IRDG/Invenio-RISCV/Documents/RiscV CompleteVersion ESP.pptx

## DISEÑO DE UN PROTOTIPO DE CONTROLADOR PID EN DRONES CON PROCESADOR A LA MEDIDA EN ARQUITECTURA RISC-V PARA IMPLEMENTACIÓN EN FPGA

- Autores:
  - Iván Ricardo Diaz Gamarra
  - Omar Steck Espinel Santamaria
  - Magda Daniela Latorre Ortiz
- Director:
  - Ing. Francisco F. Viveros, Profesor Emérito.
- Codirector:
  - Ing. Luisa F. García, Ph. D.

Notes: Omar

## Introducción

Definición de la arquitectura del procesador
Diseño de la ALU: Enfoque en suma y multiplicación
Proceso de implementación y pruebas
Descripción de control en AHPL
Formulación del proyecto - Investigación del estándar RISC-V

Notes: Daniela

## CONTEXTO DEL PROYECTO

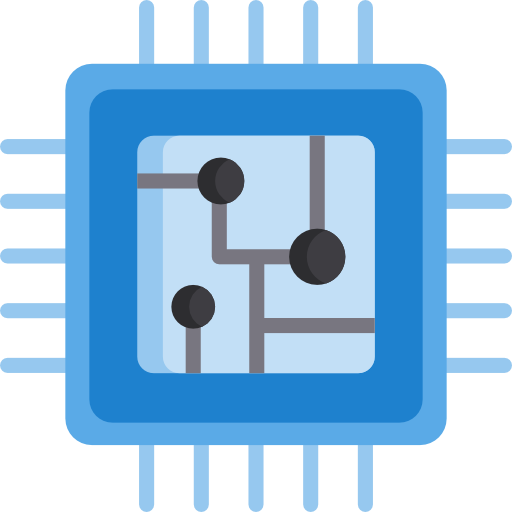
[picture p4: figure]

¿Estándares para la arquitectura de procesadores?

Iniciativas para crear un estándar para la arquitectura de procesadores.

Proyectos que permitan aplicar la arquitectura a procesadores de propósito especifico.

Notes: Omar

## FORMULACION DEL PROBLEMA

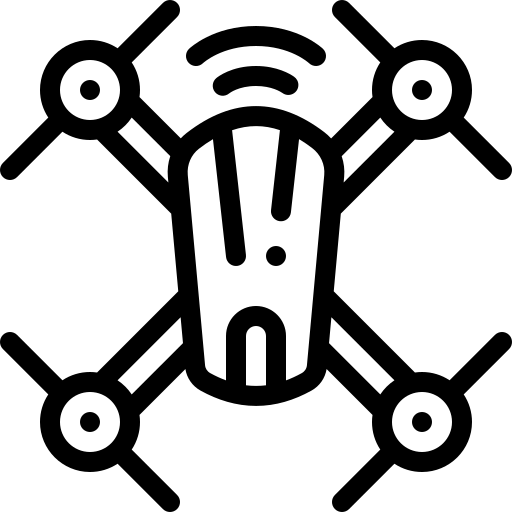
[picture p5: figure]

La ausencia de una arquitectura libre, documentada y abierta, en el ámbito de los procesadores usados en controladores de vuelo para drones, que permita estudiar la arquitectura e implementación de procesadores en ese campo y la implementación de los estándares de algún proyecto.

Oportunidad: Diseñar un procesador para esta aplicación siguiendo un estándar arquitectural.

Notes: Omar

## SOLUCION

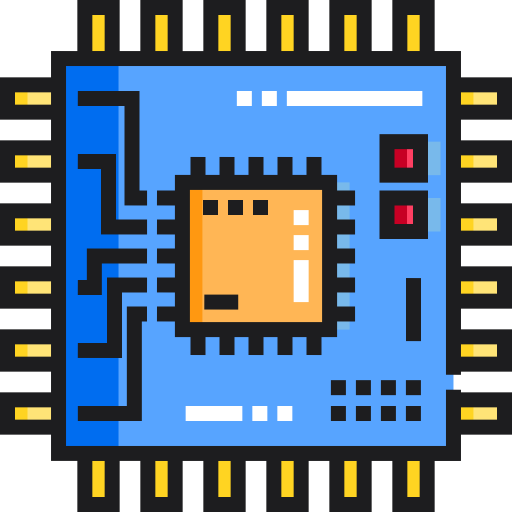
[picture p6: figure]

La creación del prototipo de un procesador a la medida, basado en la arquitectura libre RISC-V, para los controladores de vuelo de drones, cuyo proceso de diseño y decisiones arquitecturales estén debidamente documentadas para ser estudiado.

Un procesador que implementa las operaciones de un procesador de propósito general y adicionalmente implementar las instrucciones usadas en los procesadores usados para controladores de vuelo.

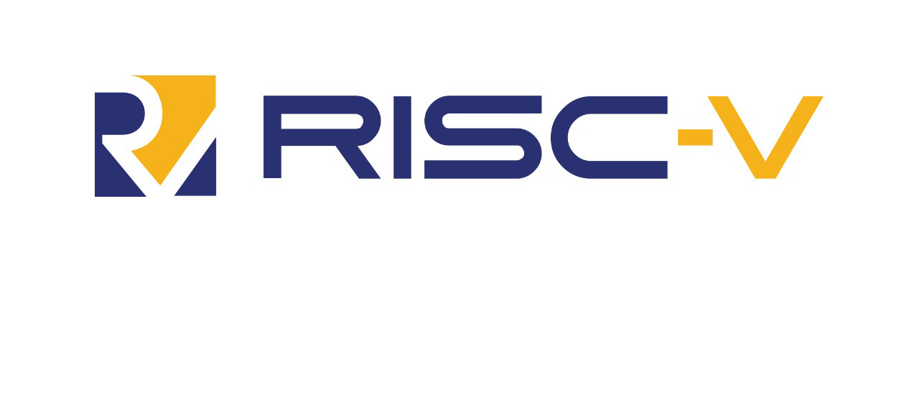
[picture p7: figure]
Los primeros procesadores basados en RISC-V llegarán pronto?

Notes: Omar

## OBJETIVO general

Diseñar el prototipo de un procesador a la medida para el controlador PID en drones, basándose en la arquitectura de conjunto de instrucciones reducido RISC-V.

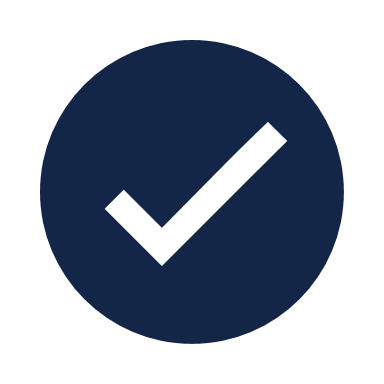
[picture p8: figure]
Marca de insignia1 con relleno sólido

Notes: Daniela

## OBJETIVOS ESPECIFICOS

- Seleccionar las instrucciones deseadas de la arquitectura RISC-V para el procesador.
- Describir el sistema en un lenguaje de transferencia de datos AHPL.
- Diseñar el procesador para la aplicación seleccionada.
- Implementar un prototipo del sistema diseñado para realizar las pruebas sobre el procesador.
- Implementar un sistema complementario de pruebas que emule las entradas de los procesadores y el microcontrolador.

Notes: Daniela

## DESCRIPCION DEL PROYECTO

- Realizar un procesador capaz de ejecutar el algoritmo PID
- La implementación del algoritmo requiere operaciones aritméticas como suma, resta y multiplicación para el calculo de los términos integrativo y derivativo
- Debido a la aplicación que se desea para este procesador es deseable que la unidad aritmético-lógica sea rápida

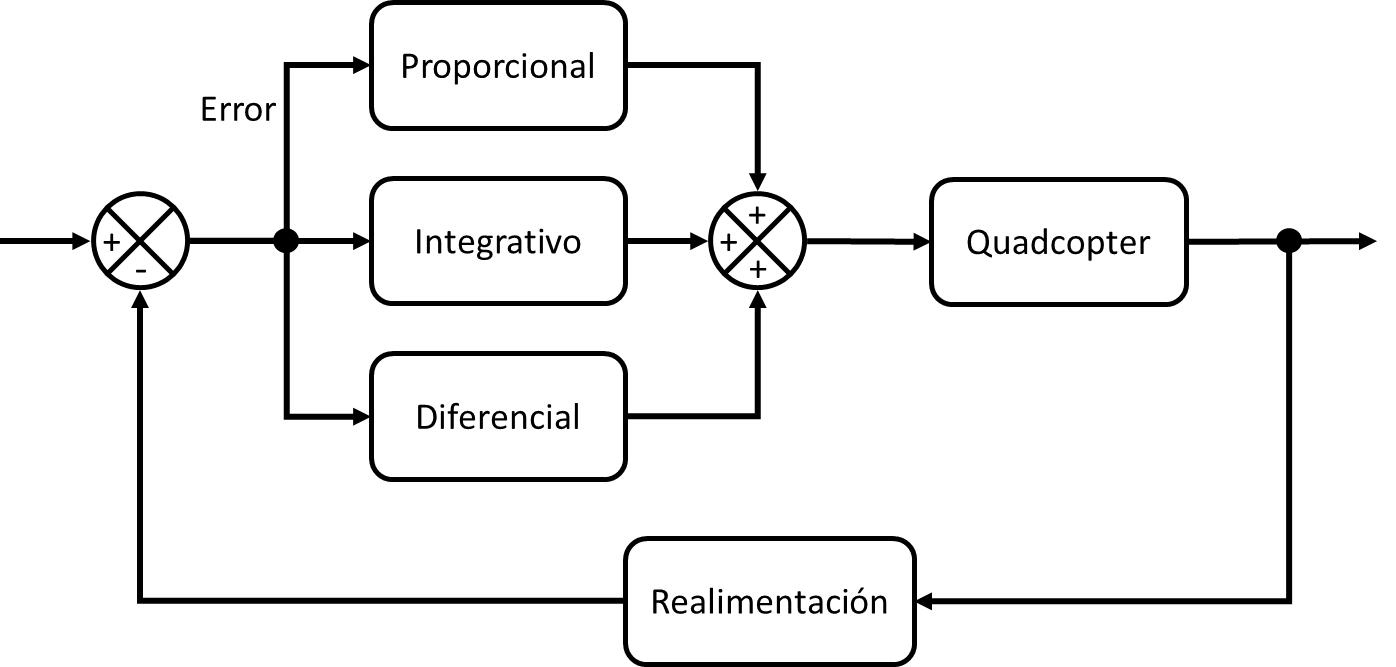
[picture p9: figure]

Notes: Ivan 40”

## TRASFONDO

Controlador de vuelo
  - Control
  - CPU
  - Manejo de señales

RISC-V
  - Que compone el RISC-V
  - Conjuntos de instrucciones
  - Directrices de diseño y de implementación

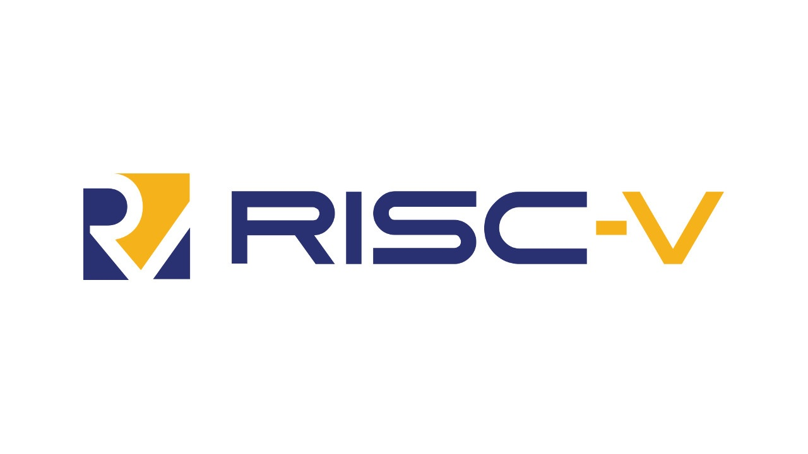
[picture p10: figure]
Los primeros procesadores basados en RISC-V llegarán pronto?

Notes: Omar

## CONTEXTO

Pixhawk
Software de control automatico
Hardware especializado para drones
MIPS
Arquitectura libre usada en procesadores.
GAP8
Procesador RISC-V
Usado en aplicaciones de control automático.
Varios proyectos privados.
Pocos proyectos independientes.

Notes: Omar

## DISEÑO

RV32I
Multiplicación
RV32IM

Set de instrucciones a implementar
Estándar
Aplicación

Notes: Daniela

## Diseño

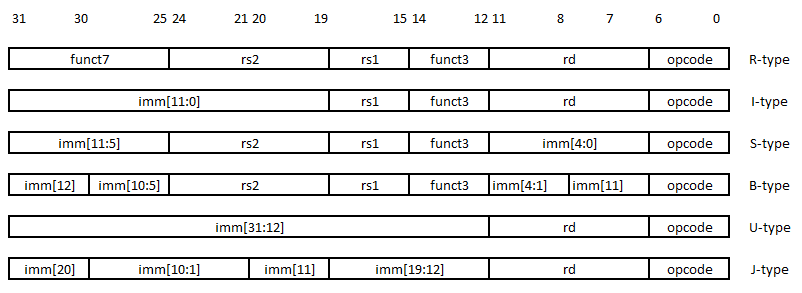
[picture p11: figure]

Formatos de instrucción
- Opcode
- Datos adicionales

Notes: Daniela

## Diseño

Instrucciones agregadas
FENCE
FENCE.I
ECALL
EBREAK
MULH
MULHSU
MULHU
MUL
SWSP
LWSP
Instrucciones descartadas

Notes: Daniela

## DIAGRAMA DE BLOQUES

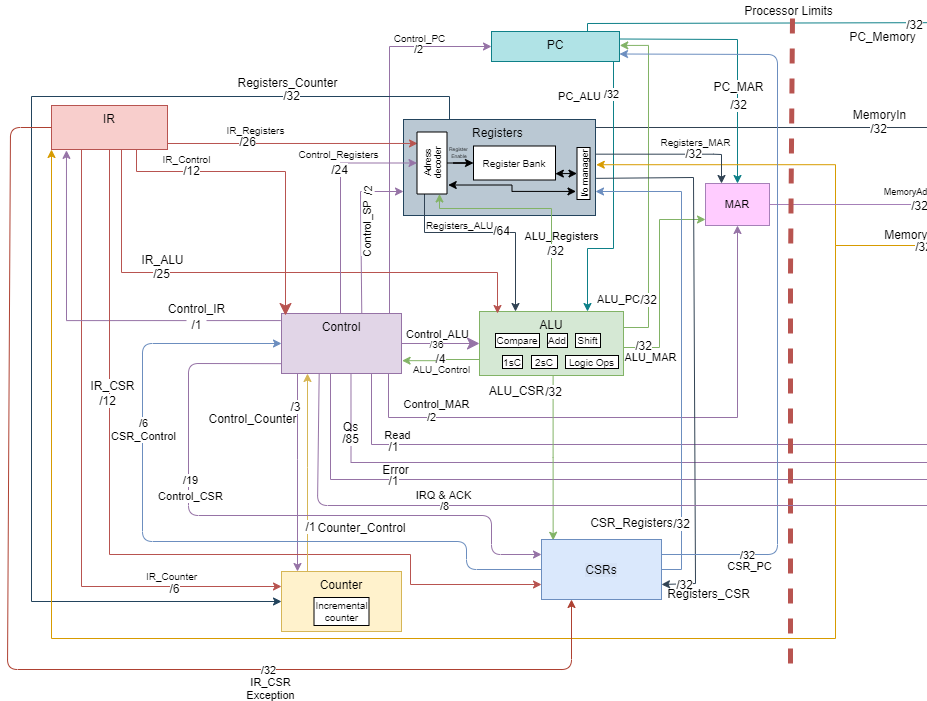
[picture p12: figure]

Notes: Ivan 3’ todo

## DIAGRAMA DE BLOQUES

DESCRIPCIÓN DE BLOQUES Y SEÑALES
ProcessorRV
IR:
PC:
Registers:
MAR:
Control:
ALU:
CSR:
Counter:
SP:

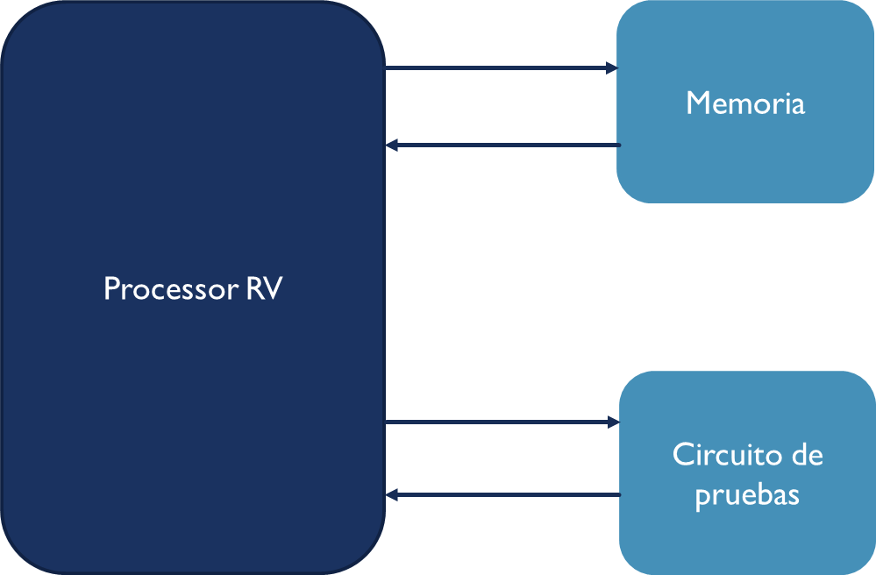
[picture p13: figure]

Notes: Ivan 3’ todo

## DIAGRAMA DE BLOQUES

- DESCRIPCIÓN DE BLOQUES Y SEÑALES
- ProcessorRV
- IR:
- PC:
- Registers:
- MAR:
- Control:
- ALU:
- CSR:
- Counter:
- SP:

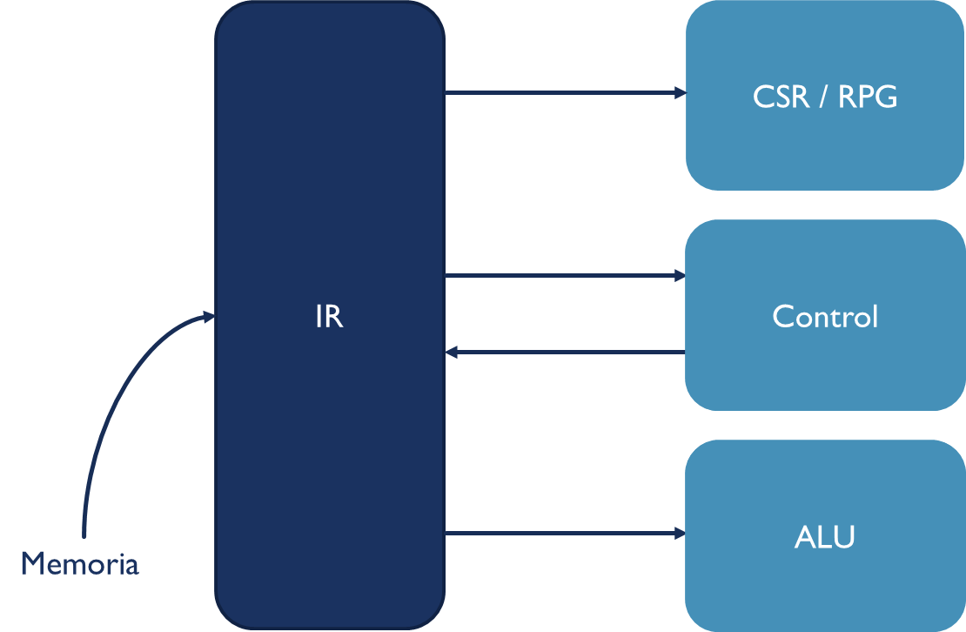
[picture p14: figure]

Notes: Ivan

## DIAGRAMA DE BLOQUES

- DESCRIPCIÓN DE BLOQUES Y SEÑALES
- ProcessorRV
- IR:
- PC:
- Registers:
- MAR:
- Control:
- ALU:
- CSR:
- Counter:
- SP:

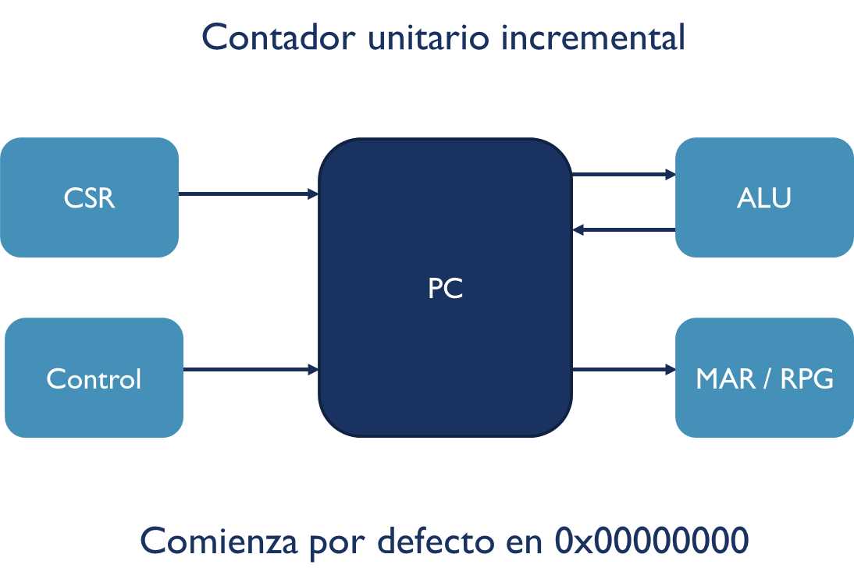
[picture p15: figure]

Notes: Ivan

## DIAGRAMA DE BLOQUES

- DESCRIPCIÓN DE BLOQUES Y SEÑALES
- ProcessorRV
- IR:
- PC:
- Registers:
- MAR:
- Control:
- ALU:
- CSR:
- Counter:
- SP:

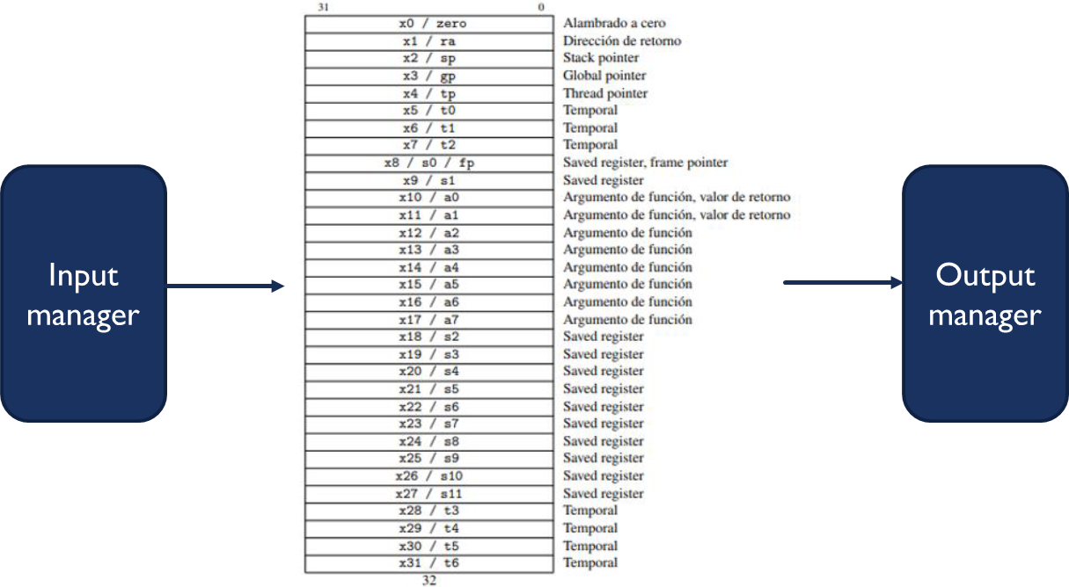
[picture p16: figure]

Notes: Ivan

## DIAGRAMA DE BLOQUES

DESCRIPCIÓN DE BLOQUES Y SEÑALES
ProcessorRV
IR:
PC:
Registers:
MAR:
Control:
ALU:
CSR:
Counter:
SP:

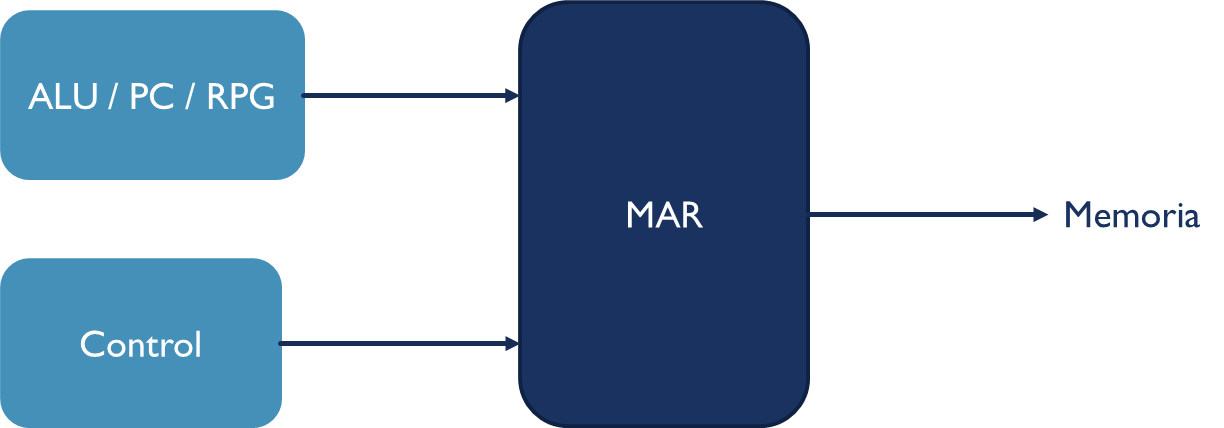
[picture p17: figure]

Notes: Ivan

## DIAGRAMA DE BLOQUES

DESCRIPCIÓN DE BLOQUES Y SEÑALES
ProcessorRV
IR:
PC:
Registers:
MAR:
Control:
ALU:
CSR:
Counter:
SP:

FSM Onehot
- Fetch
- Decode
- Excecute

- Interrupciones
- Excepción de error

101 estados

Notes: Ivan

## DIAGRAMA DE BLOQUES

DESCRIPCIÓN DE BLOQUES Y SEÑALES
ProcessorRV
IR:
PC:
Registers:
MAR:
Control:
ALU:
CSR:
Counter:
SP:

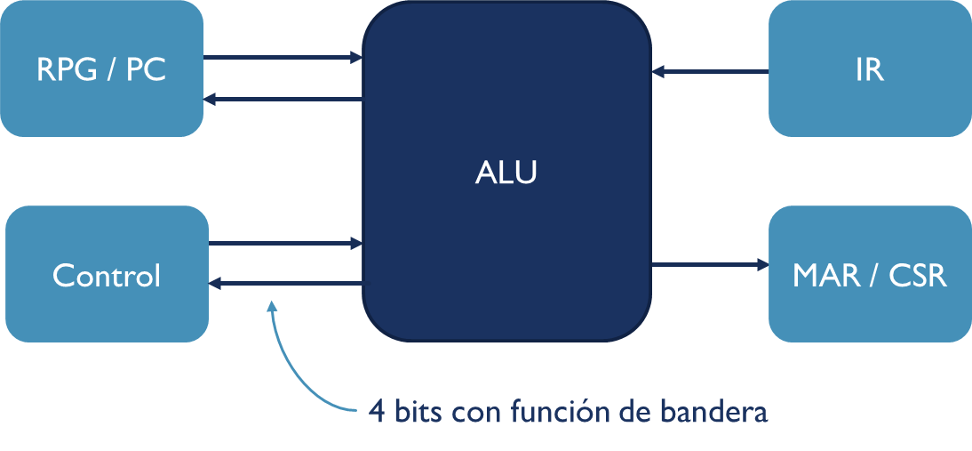
[picture p18: figure]

Notes: Ivan

## DIAGRAMA DE BLOQUES

DESCRIPCIÓN DE BLOQUES Y SEÑALES
ProcessorRV
IR:
PC:
Registers:
MAR:
Control:
ALU:
CSR:
Counter:
SP:

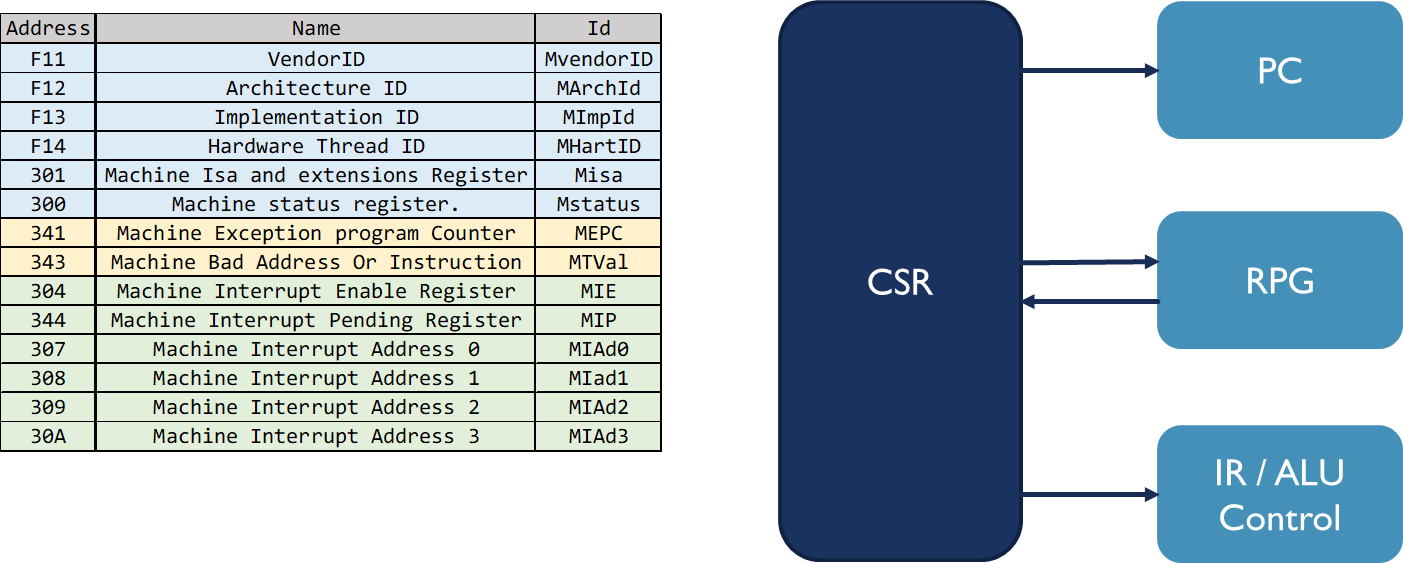
[picture p19: figure]

Notes: Ivan

## DIAGRAMA DE BLOQUES

DESCRIPCIÓN DE BLOQUES Y SEÑALES
ProcessorRV
IR:
PC:
Registers:
MAR:
Control:
ALU:
CSR:
Counter:
SP:

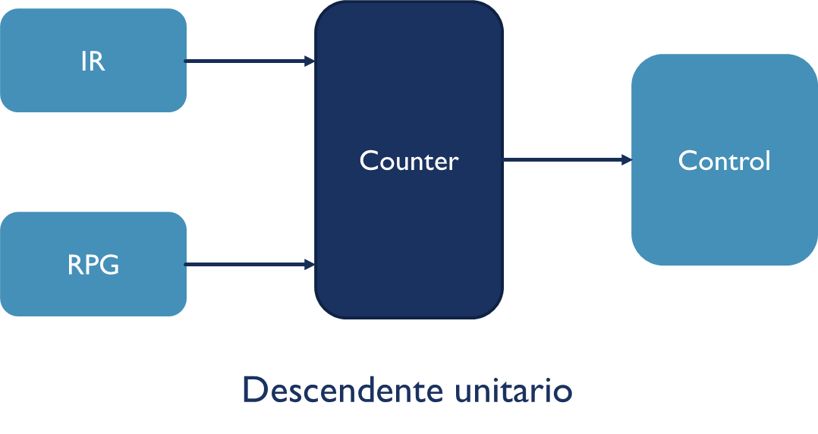
[picture p20: figure]

Notes: Ivan

## DIAGRAMA DE BLOQUES

DESCRIPCIÓN DE BLOQUES Y SEÑALES
ProcessorRV
IR:
PC:
Registers:
MAR:
Control:
ALU:
CSR:
Counter:
SP:

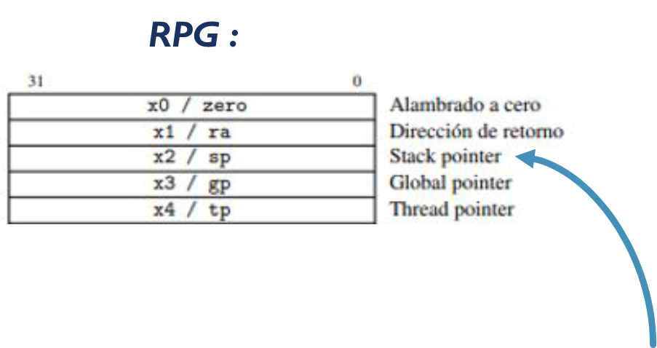
[picture p21: figure]

Notes: Ivan

## ALU EN DETALLE

- Decodificador Entrada/Salida
- Bloques de shift Aritmético y Lógico
- Operaciones lógicas
- Almacenamiento en memoria o registros

Shift lógico I
Decodificador
Shift Aritmético
Sumador
AND, OR y XOR
Multiplicador
Shift lógico D

Notes: Omar

## ALU EN DETALLE

- Sumador Ripple Carry Adder
- Sumas y restas
- Resultado depende de las compuertas
- Resultado < 1ciclo de reloj para 32 bits

Shift lógico I
Decodificador
Shift Aritmético
Sumador
AND, OR, NOT y XOR
Multiplicador
Shift lógico D

Notes: Omar

## ALU EN DETALLE

- Multiplicador modificado de Booth
- Multiplicaciones de 32 bits
- Balance entre velocidad y espacio
- Resultados en un ciclo de reloj
- Multiplicación con signo

Shift lógico I
Decodificador
Shift Aritmético
Sumador
AND, OR y XOR
Multiplicador
Shift lógico D

Notes: Omar

## IMPLEMENTACIÓN

VHDL

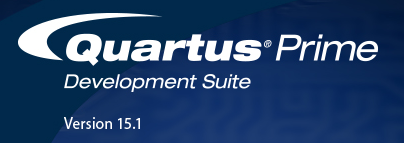
[picture p22: figure]

- Descripción en AHPL
- Lenguaje de descripción VHDL
- Uso de tableros de Trello
- Implementación del diseño en FPGA mediante Quartus
  - Asignación de tareas
  - Comprobación de funcionamiento
  - Unión de bloques

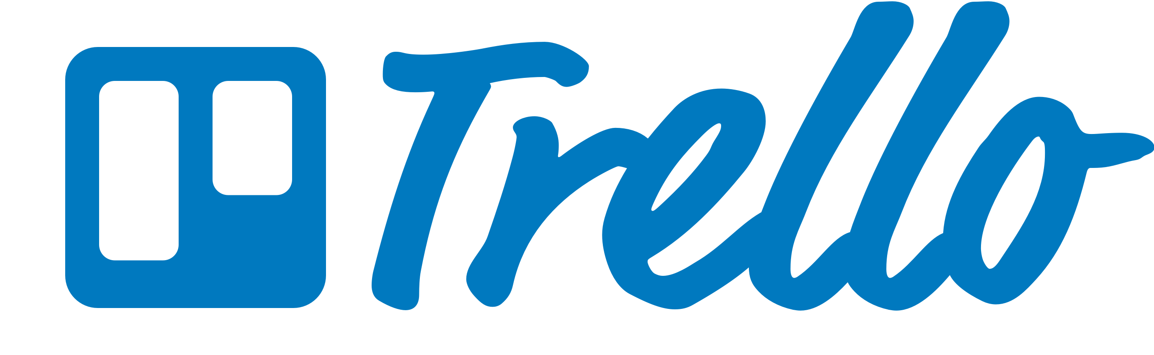
[picture p23: figure]
Trello Logo

Notes: Ivan 45”

## PRUEBAS

Simulaciones funcionales
- Quartus II
- Simulaciones con Model Sim
- Pruebas preliminares que no requieren de la FPGA
Pruebas físicas
- Quartus II
- Obtención de datos con Signal Tap
- Montaje del procesador sobre la FPGA
- Señales de las pruebas se almacenan en elementos lógicos
- Los periféricos requieren una memoria externa y un circuito de interrupciones

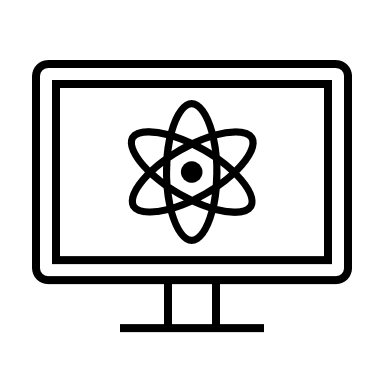
[picture p24: figure]
Aprendizaje remoto de ciencia contorno
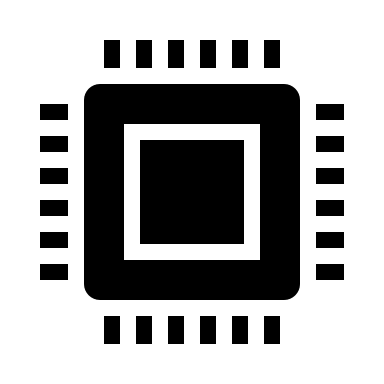
[picture p25: figure]
Procesador con relleno sólido
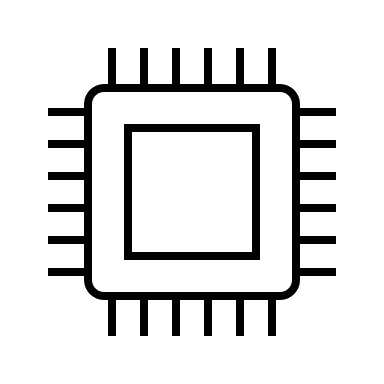
[picture p26: figure]
Procesador contorno
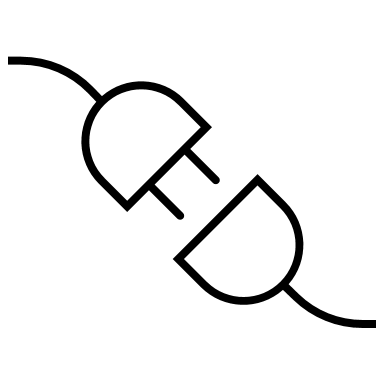
[picture p27: figure]
Conectado desconectado contorno
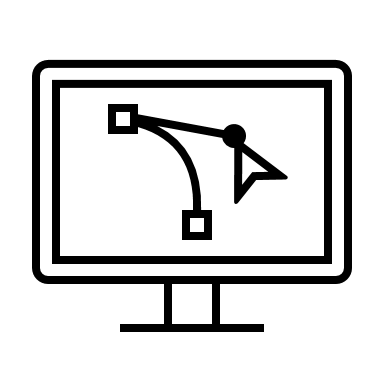
[picture p28: figure]
Ilustrador contorno

Notes: Daniela

## PRUEBAS

Protocolo de pruebas
- Tiene una agrupación de instrucciones similares
- La construcción de las instrucciones a ejecutar en binario
- La memoria se llena con las instrucciones y los datos a operar
- Se hace un compilado de los resultados esperados
- Se aprueba o no dependiendo de que coincidan según los parámetros establecidos por la instrucción

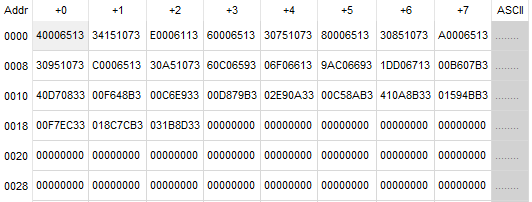
[picture p29: figure]
fsdfsdf

Memoria de prueba con direcciones y datos en hexadecimal

Tabla de instrucciones para el protocolo de pruebas

Notes: Daniela

## SIMULACIÓN DEL SISTEMA

- Para cada protocolo de pruebas se llena la memoria de forma correspondiente
- Cada protocolo de pruebas comienza con una fase de inicialización
- Para realizar las simulaciones se usa el software Model Sim
- Se evalúa cada instrucción ejecutada en cada prueba, con el fin de verificar
  - Flujo de la unidad de control
  - Funcionamiento de las instrucciones
  - Funcionamiento interno de la ALU
  - Tiempos de respuesta de la ALU
  - Funcionamiento de interrupciones y excepciones
  - Manejo de la memoria

Uso | Hex Inicio | Hex Final
User Memory | 000 | 3FF
Error | 400 | 5FF
Interruption 0 | 600 | 7FF
Interruption 1 | 800 | 9FF
Interruption 2 | A00 | BFF
Interruption 3 | C00 | DFF
Stack | E00 | FFF

Notes: Ivan 40”

## SIMULACIÓN DEL SISTEMA

Notes: Ivan 40”

## RESULTADOS

Prototipo con pruebas
Documento de diseño
Manual del procesador

Código VHDL en repositorio junto con pruebas

Diseño detallado
Arquitectura de los elementos

Descripción funcional del procesador

Notes: Omar

## VIDEO

Notes: Todos

## TRABAJO FUTURO

Implementación de modos de usuario y privilegios
Ampliar modulo de multiplicación a 64 bits
ALU para operaciones de punto flotante
Modo supervisor para interrupciones con hilos
Núcleos adicionales para implementación de hilos

Notes: Daniela

## CONCLUSIONES

- La aplicación de la arquitectura libre RISC-V en el proyecto resuelve varios elementos de diseño y facilita la implementación del proyecto, pero añade complejidad al tener que cumplir con las diferentes reglas incluidas en el estándar, su uso en este proyecto permite conocer lo que puede aportar y el alcance para proyectos similares.
- La unidad algorítmico lógica implementada, especialmente el multiplicador, funcionan como referencia para futuros trabajos, tanto pertinentes para el estándar RISC-V como para aplicaciones específicas en las que se requieren operaciones aritméticas rápidas.
- La fase de diseño de un sistema es la mas larga e importante, ya que define exactamente que se va a implementar, como se hará y con qué metodología se probará. A su vez, esta requiere un entendimiento del problema del que se parte y del estándar con el que se trabaja, ya que en el caso del RISC-V determinó que instrucciones teníamos disponibles, como se debían tratar y desde ahí se desarrollo el resto del proyecto.

Notes: Todos

## PREGUNTAS

Notes: Todos

## GRACIAS

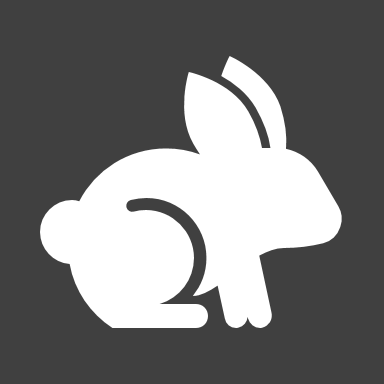
[picture p30: figure]
Conejo con relleno sólido

Notes: c:

## REFERENCIAS DE LA PRESENTACION

- Imágenes tomadas de: www.flaticon.com
- RISC-V icono, tomado de: https://elandroidelibre.elespanol.com/wp-content/uploads/2019/06/Risc-V-1.jpg
- Icono Trello, tomado de: https://trello.com/about/logo
- Icono Quartus prime 15.1 tomado del inicio de la aplicacion
