IRDG/Invenio-RISCV/BlockDiagramRISC-V-diagrama de bloques.png

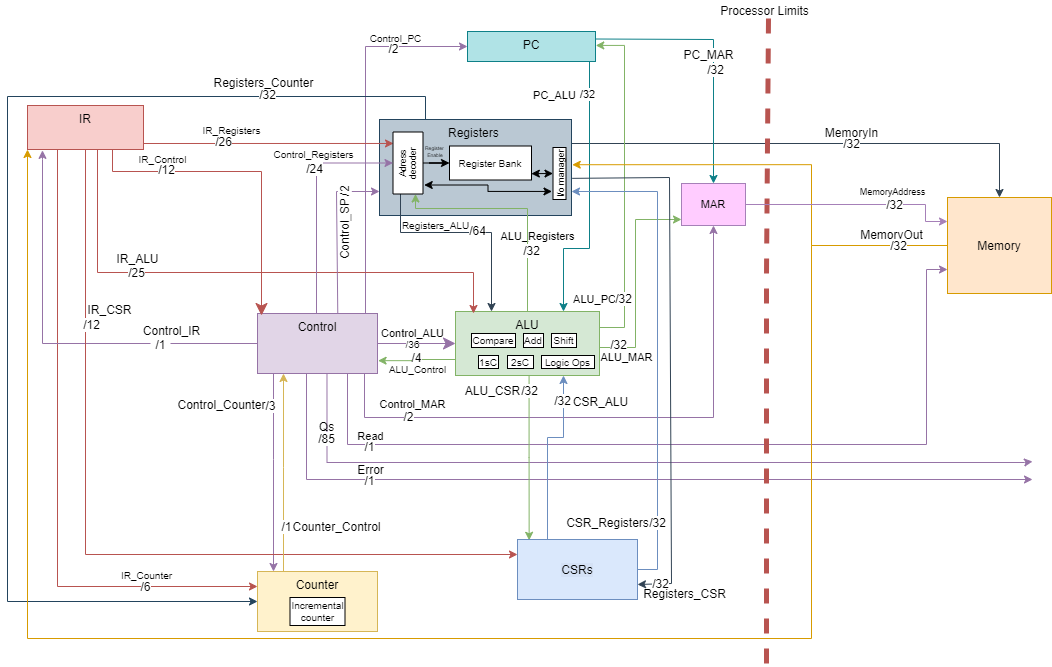
BlockDiagramRISC-V-diagrama de bloques.png
